gregariouspanda/mission_control/kicad/mission_control.kicad_sch

## KiCad design kicad/mission_control.kicad_sch (2026-11-04)

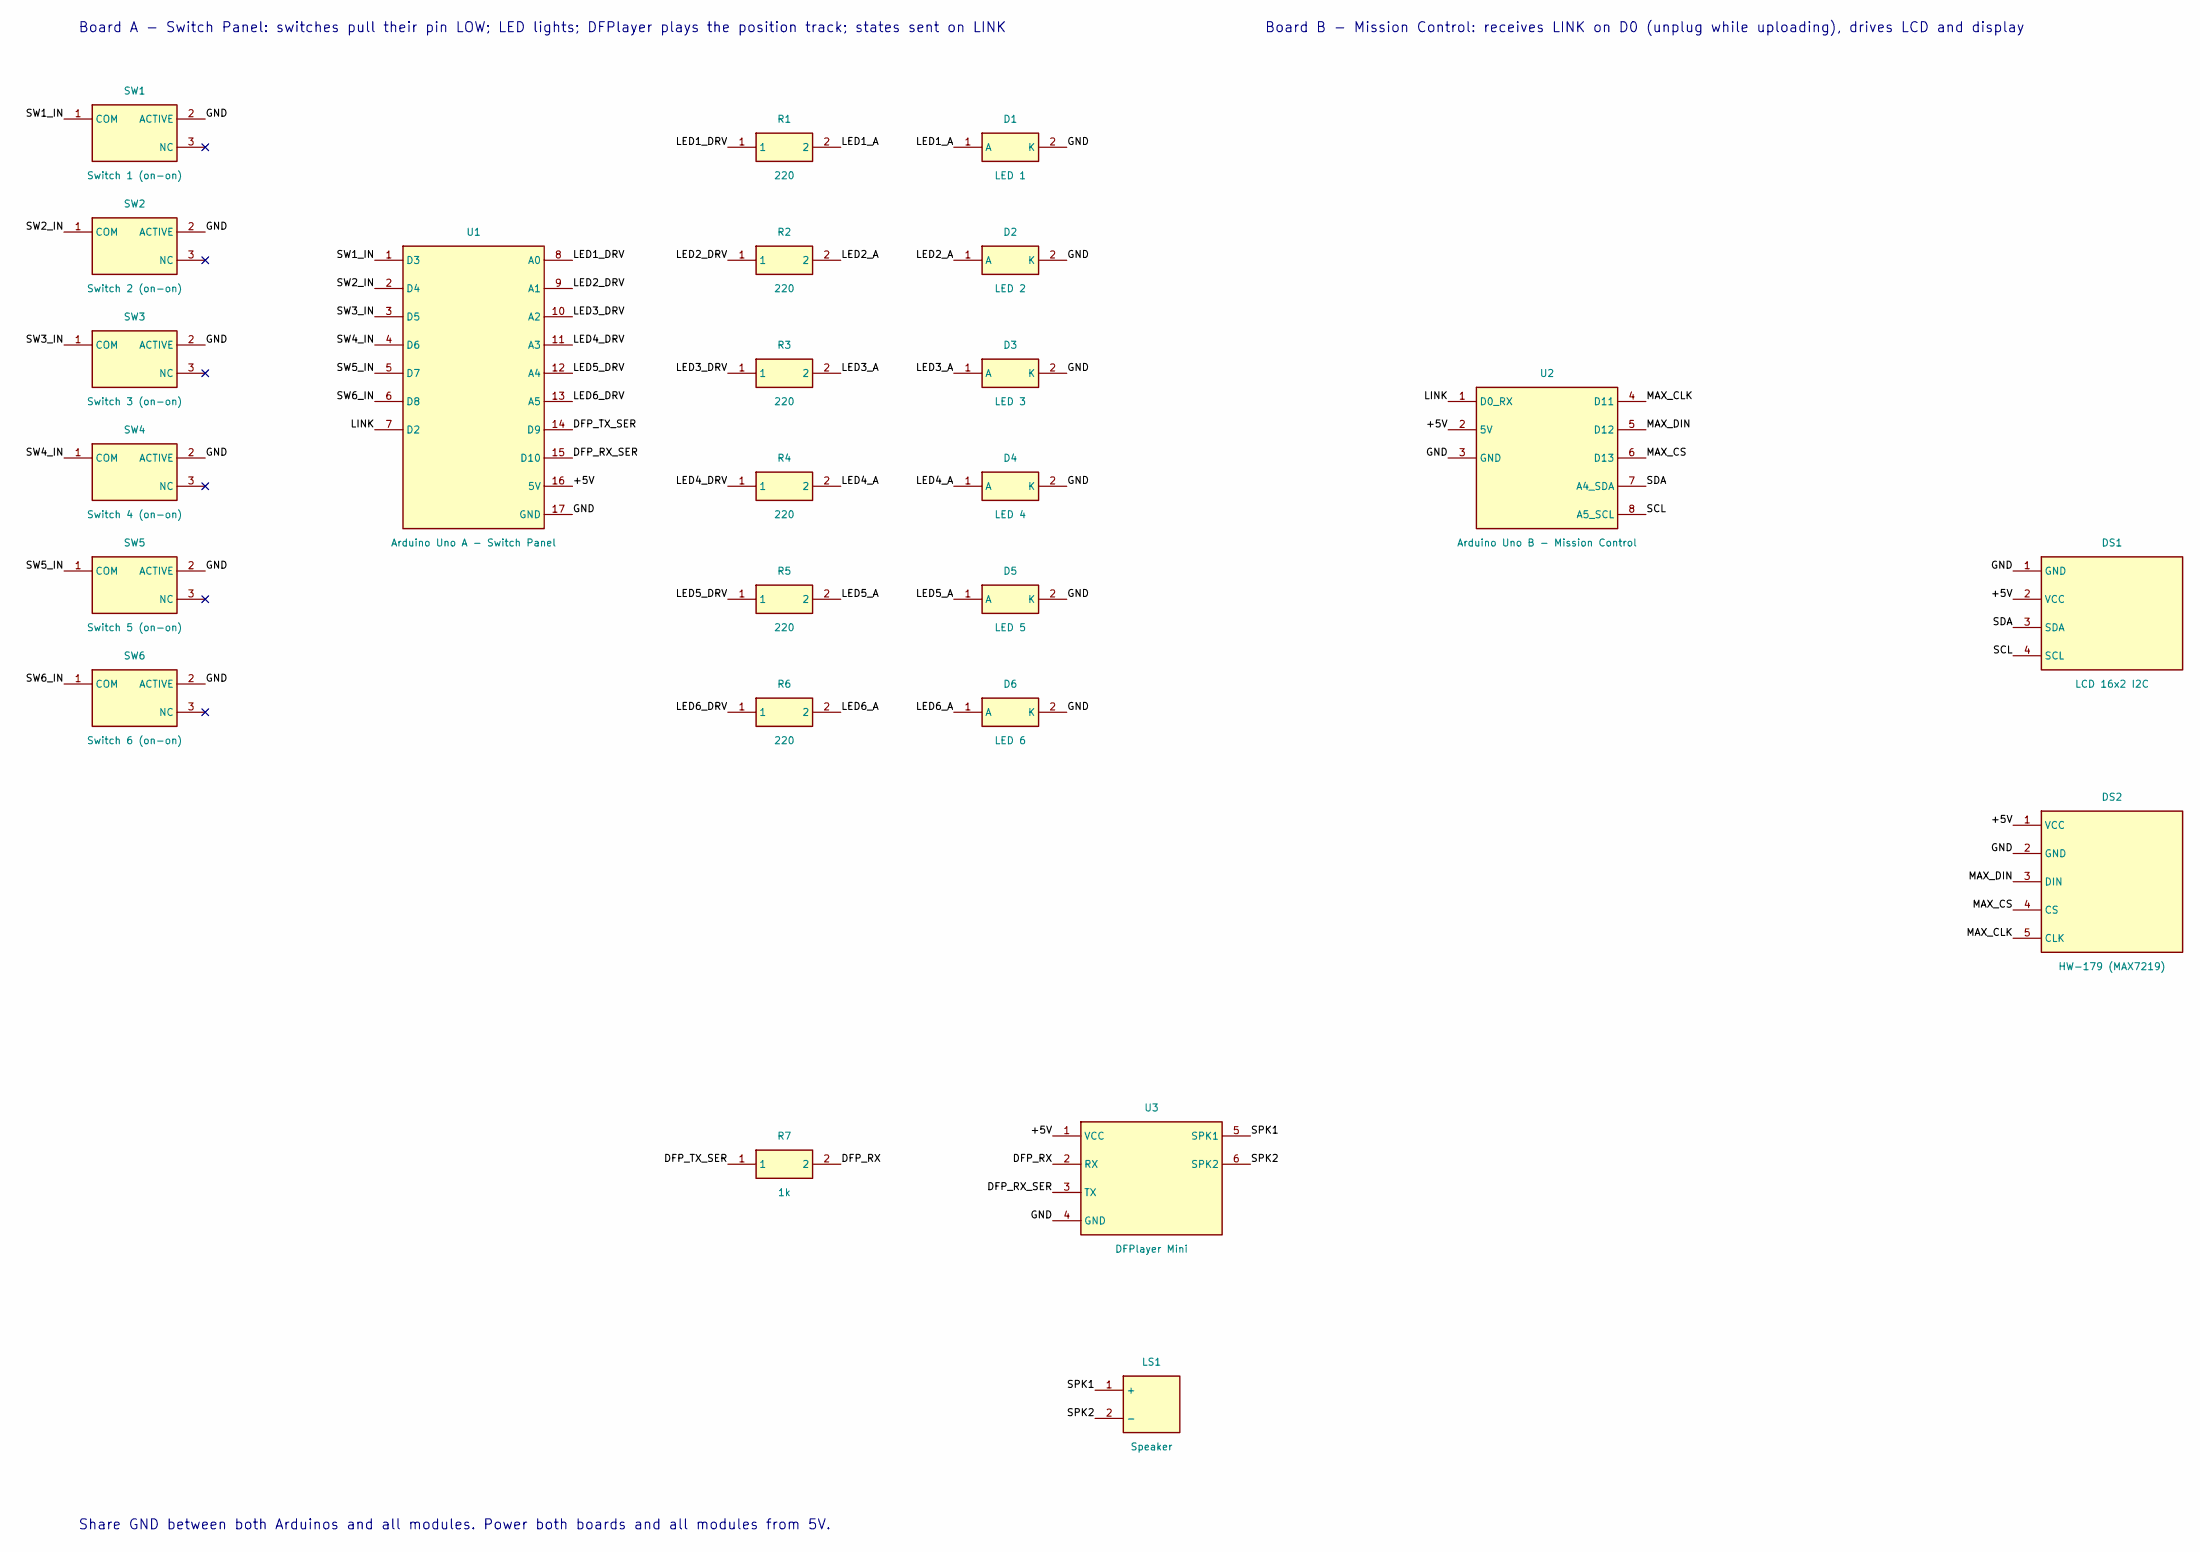
[picture p1: schematic mission_control.kicad_sch]

Parts:
D1: LED 1
D2: LED 2
D3: LED 3
D4: LED 4
D5: LED 5
D6: LED 6
DS1: LCD 16x2 I2C
DS2: HW-179 (MAX7219)
LS1: Speaker
R1, R2, R3, R4, R5, R6: 220
R7: 1k
SW1: Switch 1 (on-on)
SW2: Switch 2 (on-on)
SW3: Switch 3 (on-on)
SW4: Switch 4 (on-on)
SW5: Switch 5 (on-on)
SW6: Switch 6 (on-on)
U1: Arduino Uno A - Switch Panel
U2: Arduino Uno B - Mission Control
U3: DFPlayer Mini

Connections:
+5V: DS1.2 (VCC), DS2.1 (VCC), U1.16 (5V), U2.2 (5V), U3.1 (VCC)
DFP_RX: R7.2, U3.2 (RX)
DFP_RX_SER: U1.15 (D10), U3.3 (TX)
DFP_TX_SER: R7.1, U1.14 (D9)
GND: D1.2 (K), D2.2 (K), D3.2 (K), D4.2 (K), D5.2 (K), D6.2 (K), DS1.1 (GND), DS2.2 (GND), SW1.2 (ACTIVE), SW2.2 (ACTIVE), SW3.2 (ACTIVE), SW4.2 (ACTIVE), SW5.2 (ACTIVE), SW6.2 (ACTIVE), U1.17 (GND), U2.3 (GND), U3.4 (GND)
LED1_A: D1.1 (A), R1.2
LED1_DRV: R1.1, U1.8 (A0)
LED2_A: D2.1 (A), R2.2
LED2_DRV: R2.1, U1.9 (A1)
LED3_A: D3.1 (A), R3.2
LED3_DRV: R3.1, U1.10 (A2)
LED4_A: D4.1 (A), R4.2
LED4_DRV: R4.1, U1.11 (A3)
LED5_A: D5.1 (A), R5.2
LED5_DRV: R5.1, U1.12 (A4)
LED6_A: D6.1 (A), R6.2
LED6_DRV: R6.1, U1.13 (A5)
LINK: U1.7 (D2), U2.1 (D0_RX)
MAX_CLK: DS2.5 (CLK), U2.4 (D11)
MAX_CS: DS2.4 (CS), U2.6 (D13)
MAX_DIN: DS2.3 (DIN), U2.5 (D12)
SCL: DS1.4 (SCL), U2.8 (A5_SCL)
SDA: DS1.3 (SDA), U2.7 (A4_SDA)
SPK1: LS1.1 (+), U3.5 (SPK1)
SPK2: LS1.2 (-), U3.6 (SPK2)
SW1_IN: SW1.1 (COM), U1.1 (D3)
SW2_IN: SW2.1 (COM), U1.2 (D4)
SW3_IN: SW3.1 (COM), U1.3 (D5)
SW4_IN: SW4.1 (COM), U1.4 (D6)
SW5_IN: SW5.1 (COM), U1.5 (D7)
SW6_IN: SW6.1 (COM), U1.6 (D8)

Notes on the sheet:
Board A - Switch Panel: switches pull their pin LOW; LED lights; DFPlayer plays the position track; states sent on LINK
Board B - Mission Control: receives LINK on D0 (unplug while uploading), drives LCD and display
Share GND between both Arduinos and all modules. Power both boards and all modules from 5V.
