gregariouspanda/mission_control/(commit log)

2026-10-25 Add mission control sketch and wiring docs
2026-10-29 Add Switch 6 on D8 and per-switch LCD messages
    The most recent switch toggle now controls the LCD message.
2026-10-29 Split into Switch Panel and Mission Control sketches
    Board A reads the six switches, drives the LEDs and sends states over serial.
    Board B receives them and drives the DFPlayer, LCD and display.
2026-10-29 Add KiCad schematic and generator script
    [mission_control.kicad_sch]
2026-10-31 Show timer as HH.MM.SS.cc and add a test timer rotation
2026-11-04 Move DFPlayer to the Switch Panel; track and LCD message follow switch position
    Also set MAX7219 CS HIGH before making it an output, and update the README and KiCad schematic.
    [mission_control.kicad_sch]
2026-11-04 Add combined pin chart to README
2026-11-04 Remove the reset button from board B (sketch, README, KiCad)
    [mission_control.kicad_sch]
2026-11-08 Play a new track when a switch turns OFF; LCD shows 'Switch X active'
2026-11-09 Make Switch 6 a plain on/off switch (OFF stops audio)
